IrisYe-302/SOLACE/web/assets/solace-mark.png

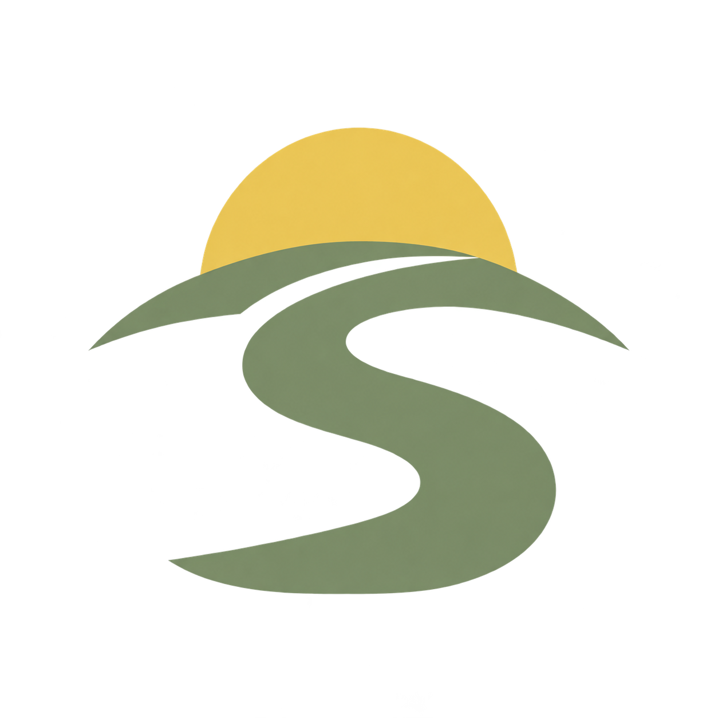
web/assets/solace-mark.png
