IrisYe-302/SOLACE/firmware/SOLACE/MotionController.h

#pragma once

#include <Arduino.h>

class MotionController {
 public:
  void begin();
  void track(float azimuthError, float elevationError);
  void moveToward(float azimuthTarget, float elevationTarget);
  void hold();
  float azimuth() const { return azimuthDeg_; }
  float elevation() const { return elevationDeg_; }

 private:
  void attachPwm();
  void writeServo(uint8_t pin, uint8_t legacyChannel, float angleDeg,
                  uint16_t minimumUs, uint16_t maximumUs, bool reversed);
  void writeAngles();
  float trackingStep(float error, int8_t &lastDirection,
                     uint8_t &confirmationCount);
  float azimuthDeg_ = 90;
  float elevationDeg_ = 90;
  int8_t azimuthDirection_ = 0;
  int8_t elevationDirection_ = 0;
  uint8_t azimuthConfirmationCount_ = 0;
  uint8_t elevationConfirmationCount_ = 0;
};
