IrisYe-302/SOLACE/firmware/SOLACE/Secrets.example.h

#pragma once

// Copy this file to Secrets.h and replace the example values locally.
// Secrets.h is ignored by Git and must not be committed.
#define SOLACE_WIFI_SSID "your-network-name"
#define SOLACE_WIFI_PASSWORD "your-network-password"
