IrisYe-302/SOLACE/(commit log)

2026-10-25 change wiring assumptions for 5v cc rail
2026-10-25 fix board target, servo pwm, and pin placments
    [Config.h, LdrArray.cpp, MotionController.cpp, OccupancySensor.cpp, SOLACE.ino, ShadeOptimizer.cpp, SolaceNetworkManager.cpp, SolaceNetworkManager.h]
2026-10-25 Consolidate ESP32-S3 firmware and shade control
